JyeSmith/dshot-esc-tester/data/EMAX RS2306 2400KV/8_turn_cyclone_5050.csv.plot.png

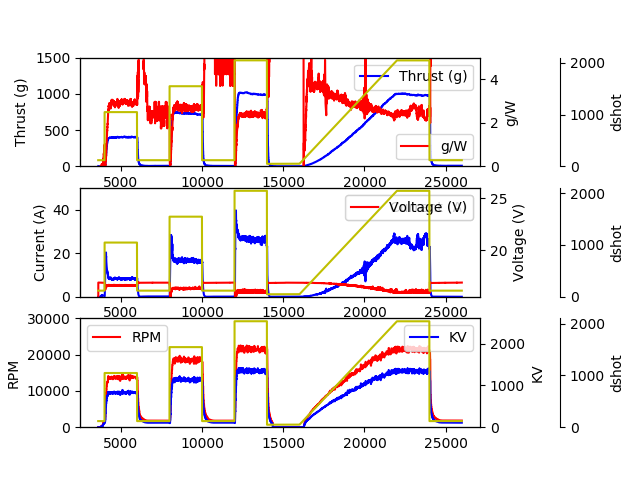
data/EMAX RS2306 2400KV/8_turn_cyclone_5050.csv.plot.png
