JyeSmith/dshot-esc-tester/data/EMAX RS2306 2400KV/11_turn - 6s - 4.csv.plot.png

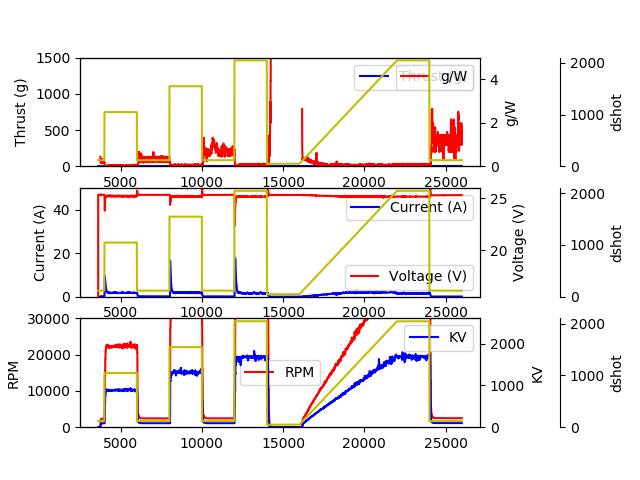
data/EMAX RS2306 2400KV/11_turn - 6s - 4.csv.plot.png
