JyeSmith/dshot-esc-tester/data/EMAX RS2306 2400KV/11_turn_cyclone_5050 - 6s.csv.plot.png

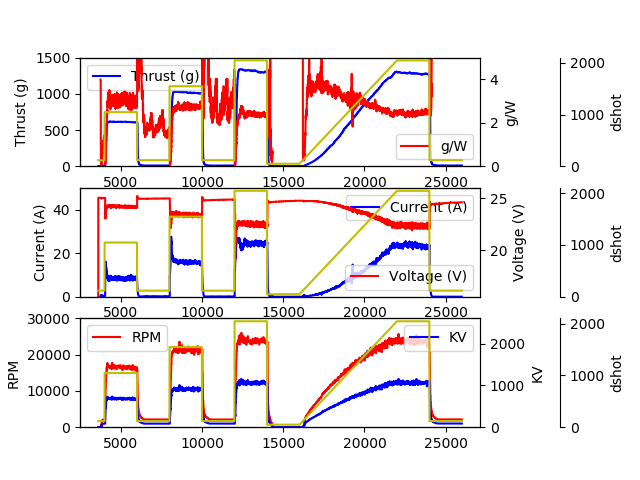
data/EMAX RS2306 2400KV/11_turn_cyclone_5050 - 6s.csv.plot.png
