JyeSmith/dshot-esc-tester/data/EMAX RS2306 2400KV/comparison plots 6s three motors.png

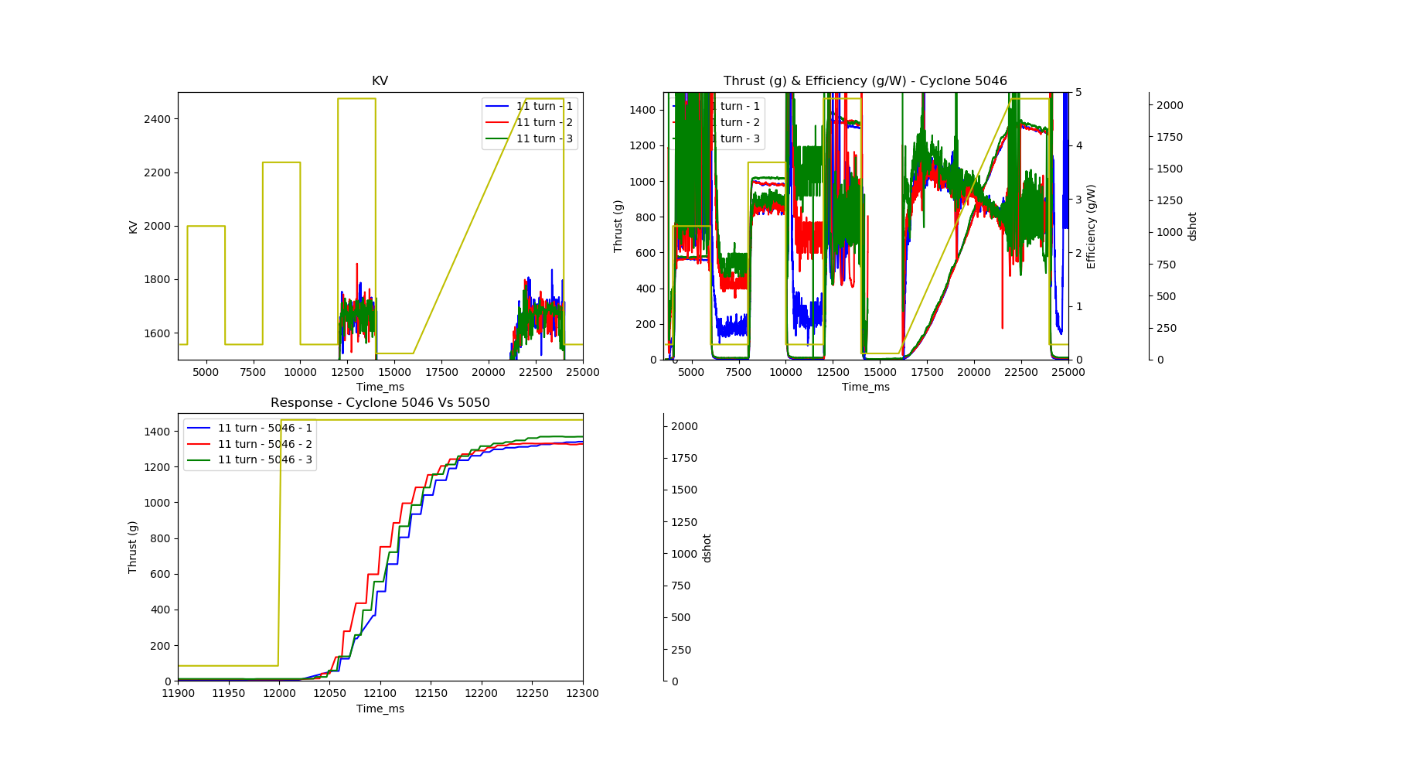
data/EMAX RS2306 2400KV/comparison plots 6s three motors.png
