JyeSmith/dshot-esc-tester/data/EMAX RS2306 2400KV/original_cyclone_5050.csv.plot.png

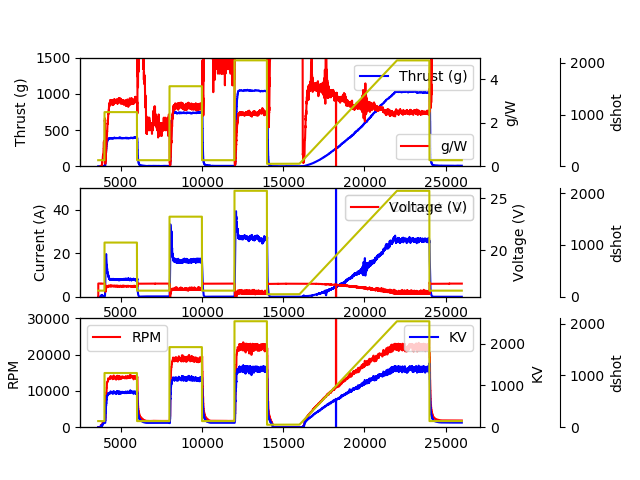
data/EMAX RS2306 2400KV/original_cyclone_5050.csv.plot.png
