JyeSmith/dshot-esc-tester/data/EMAX RS2306 2400KV/plots.png

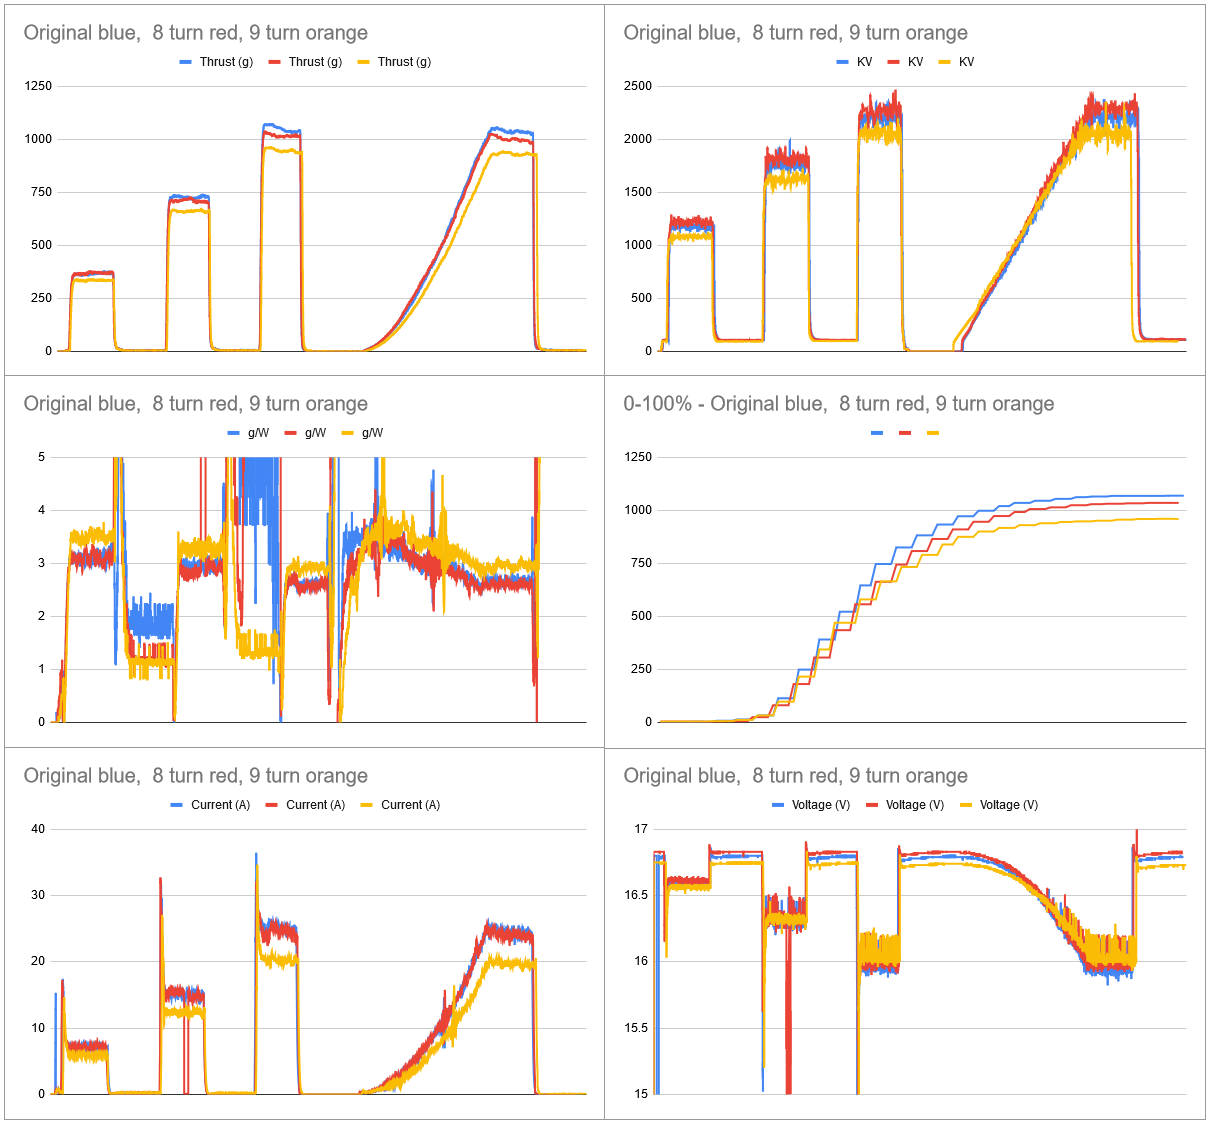
data/EMAX RS2306 2400KV/plots.png
