JyeSmith/dshot-esc-tester/(threads)

Thread 4 (2019-11-08):

Struggling with serial connection with ESC

h-brenne, 2019-11-08:
I'm trying to make a thrust stand based on the dshot setup of this repo. I've got the excact same ESP32 module as described, and I'm using an Airbot Wraith32 V2. I've connected the telemetry signal to RX2, pin 16, and dshot signal to TX2, pin 17, and also ground from the battery to the ESP32. I've also tried other pin combinations and updated the hardwareserial setup. I've also tried another ESP32 and another ESC. Still, I can't seem to get any communication going.  The serial connection is only available when unplugging cables or powering the ESC, and no data is received. Do you have any idea what might be wrong?

JyeSmith, 2019-11-08:
Check out the schematic below from the readme.  TLM connects to RX2 but the dshot signal wire connects to GPIO5.

https://easyeda.com/jyesmith/kv-meter

h-brenne, 2019-11-09:
Thanks, works now!

Closed 2019-11-09.

Thread 5 (2020-05-31):

ESP32 as FCS - ESC's (blheli32)

europer, 2020-05-31:
Hi,
new into drones regards programming and in my project (homematic what is lot easier programming then drones) I use only esp32 since they are great and cheap and like to program with them.
Then I wanted to start with a new project and this is to make a drone controlled with esp32 as master of desaster ;) I fast did see that esp32 is not the prefered mc and most ESC now use Dshot150-1200, singleshot, multishot and not what I did see the classic old PWM as I was used to in other project (where speed and etc etc was perhaps not so importand and small deviation due to noice into the analog signal)
So sorry for my perhaps dum/bold questions since I see this is the bottleneck for me in the consept phase is to controll the ESC with the ESP32 (as FS). So here my questions:

1. you have made a Dshot600 protocoll for esp32?
2. since the esp32 use 3.3v gpio but I mean the input for the ESC are 5v how to you overcome this issue?
3. is ist possible with the esp32 to have 4 x the protocoll (dshot600) to controll the ESC for again to controll the 4 motors?
4. is your protocoll also without need of calibration what should be one of the advantage of the dshot?
5. do your protocoll also give a check sum to controll that right data was transmitted?

reason for my questions is as I did statet above is to make my own FS with esp32 but implemtent the new protocoll dshot for controlling the ESC what can use this protocoll => programming FS for a drone with esp32

thanks and happy weekend
europer

JyeSmith, 2020-05-31:
Hi @europer

Just in case you havent found it, did you look at the Betaflight firmware?  A lot more work has been done with stm32 MCUs.

>     1. you have made a Dshot600 protocoll for esp32?

DS150 and 300 are also perfectly fine.  Do not get too hung up with using the absolutely fastest protocol.

https://github.com/JyeSmith/dshot-esc-tester/blob/8695f27fb705892a0906acddc60b4a4e8dfb21a3/dshot-esc-tester.ino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

>     2. since the esp32 use 3.3v gpio but I mean the input for the ESC are 5v how to you overcome this issue?

This is not a problem.  MCUs on ESCs are happy with3.3V signal.

>     3. is ist possible with the esp32 to have 4 x the protocoll (dshot600) to controll the ESC for again to controll the 4 motors?

I am not sure and never looked that far.

>     4. is your protocoll also without need of calibration what should be one of the advantage of the dshot?

Correct. DShot does not require any calibration since it is a digital signal.

>     5. do your protocoll also give a check sum to controll that right data was transmitted?

https://github.com/JyeSmith/dshot-esc-tester/blob/8695f27fb705892a0906acddc60b4a4e8dfb21a3/dshot-esc-tester.ino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

europer, 2020-06-02:
Thanks for the answer 👍 good job.

Closed 2022-03-17.

Thread 6 (2022-01-17):

Library that you using

ariefadha, 2022-01-17:
I have difficult to compile this on Arduino IDE. what SSD1306.h and HX711.h that it use?

trymaslenok, 2022-08-23:
Hello! Can you tell me what needs to be changed in the code to use your project for BlHeli_S

neo3exe, 2022-08-24:
> Hello! Can you tell me what needs to be changed in the code to use your project for BlHeli_S

please start a new issue instead of adding to this one.
This was built way back before BlHeli_S had dshot/telemetry. Now you could actually see the rpm values in betaflight configurator when performing a motor test
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

amritsingh87, 2023-06-16:
Same as OP, can you please give links to the libraries you are using - especially Free RTOS
