JyeSmith/dshot-esc-tester/(commit log)

2018-10-05 Increase startup time for ESC initialization
2019-06-15 readme, pcb, images
2019-07-20 move rmt to other core
    Also cleans up tlm reads and adds a back up tlm call on a HW timer in case the ESC does not receive a request. Previously this would prevent any future tlm request from being made.
    [dshot-esc-tester.ino]
2019-07-27 bb data
    motor testing
2019-08-22 adds miniquadtestbench test sequence
    https://www.miniquadtestbench.com/motor-explorer.html
2019-08-25 remove serial print
2019-08-25 adds test data
    [EMAX RS2306 2400KV.xlsx]
2019-08-26 adds python plots
    [8_turn.csv, 8_turn_cyclone_5046.csv, 8_turn_cyclone_5050.csv, 9_turn.csv, 9_turn_cyclone_5046.csv, 9_turn_cyclone_5050.csv, original.csv, original_cyclone_5046.csv]
2019-08-30 adds 11 turn motor data on 4s and 6s
    Emax RS2306 with 11 turns 0.5mm wire.
    Also adds drop n plot script for quickly viewer data.
    [11_turn - 6s.csv, 11_turn.csv, 11_turn_cyclone_5046 - 6s - noisy.csv, 11_turn_cyclone_5046 - 6s.csv, 11_turn_cyclone_5046.csv, 11_turn_cyclone_5050 - 6s.csv, 11_turn_cyclone_5050.csv, EMAX RS2306 2400KV.xlsx]
2019-08-31 adds 11 turn multistrand 6s data
    [11_turn - 6s multistrand.csv, 11_turn_cyclone_5046 - 6s multistrand.csv, 11_turn_cyclone_5050 - 6s multistrand.csv]
2019-09-08 comparison data between four 11 turn motors
    [11_turn - 6s - 2.csv, 11_turn - 6s - 3.csv, 11_turn - 6s - 4.csv, 11_turn_cyclone_5046 - 6s - 2.csv, 11_turn_cyclone_5046 - 6s - 3.csv]
2019-10-30 fix kv throttle scaling
    [dshot-esc-tester.ino]
